KoNaR-Hefajstos/MMS3_hat_thermocouple/jlcpcb/production_files/BOM-MMS3_hat_templates.csv

Comment | Designator | Footprint | LCSC | Quantity
100nF | C1,C10,C11,C12,C2,C4,C5,C6,C7,C8,C9 | C_0603 | C14663 | 11
10kΩ | R1,R2,R3,R5,R8,R9 | R_0402 | C25744 | 6
10uF | C16,C17,C18 | C_0603 | C19702 | 3
330Ω | R10,R11,R12,R13,R14,R15,R16,R17,R20 | R_0402 | C25104 | 9
AMS1117 | U13 | SOT-223-3_L6.5-W3.4-P2.30-LS7.0-BR | C6186 | 1
M24C64 | U2 | SOIC-8_L5.0-W4.0-P1.27-LS6.0-BL | C79988 | 1
MAX31855KASA+T | U16,U17,U18,U19,U20,U21,U22,U5 | SO-8_L4.9-W3.9-P1.27-LS5.9-BL | C52028 | 8
Red | D11,D12,D13,D14,D15,D16,D17,D18,D20 | D_0603 | C2286 | 9
SN74CB3Q3245PWR | U1 | TSSOP-20_L6.5-W4.4-P0.65-LS6.4-BL | C470961 | 1
TCA9535PWR_C130204 | U14 | TSSOP-24_L7.8-W4.4-P0.65-LS6.4-BL | C130204 | 1
