KoNaR-Hefajstos/MMS3_hat_thermocouple/MMS3_hat_templates.kicad_pcb

## KiCad design MMS3_hat_templates.kicad_pcb (2026-06-24)

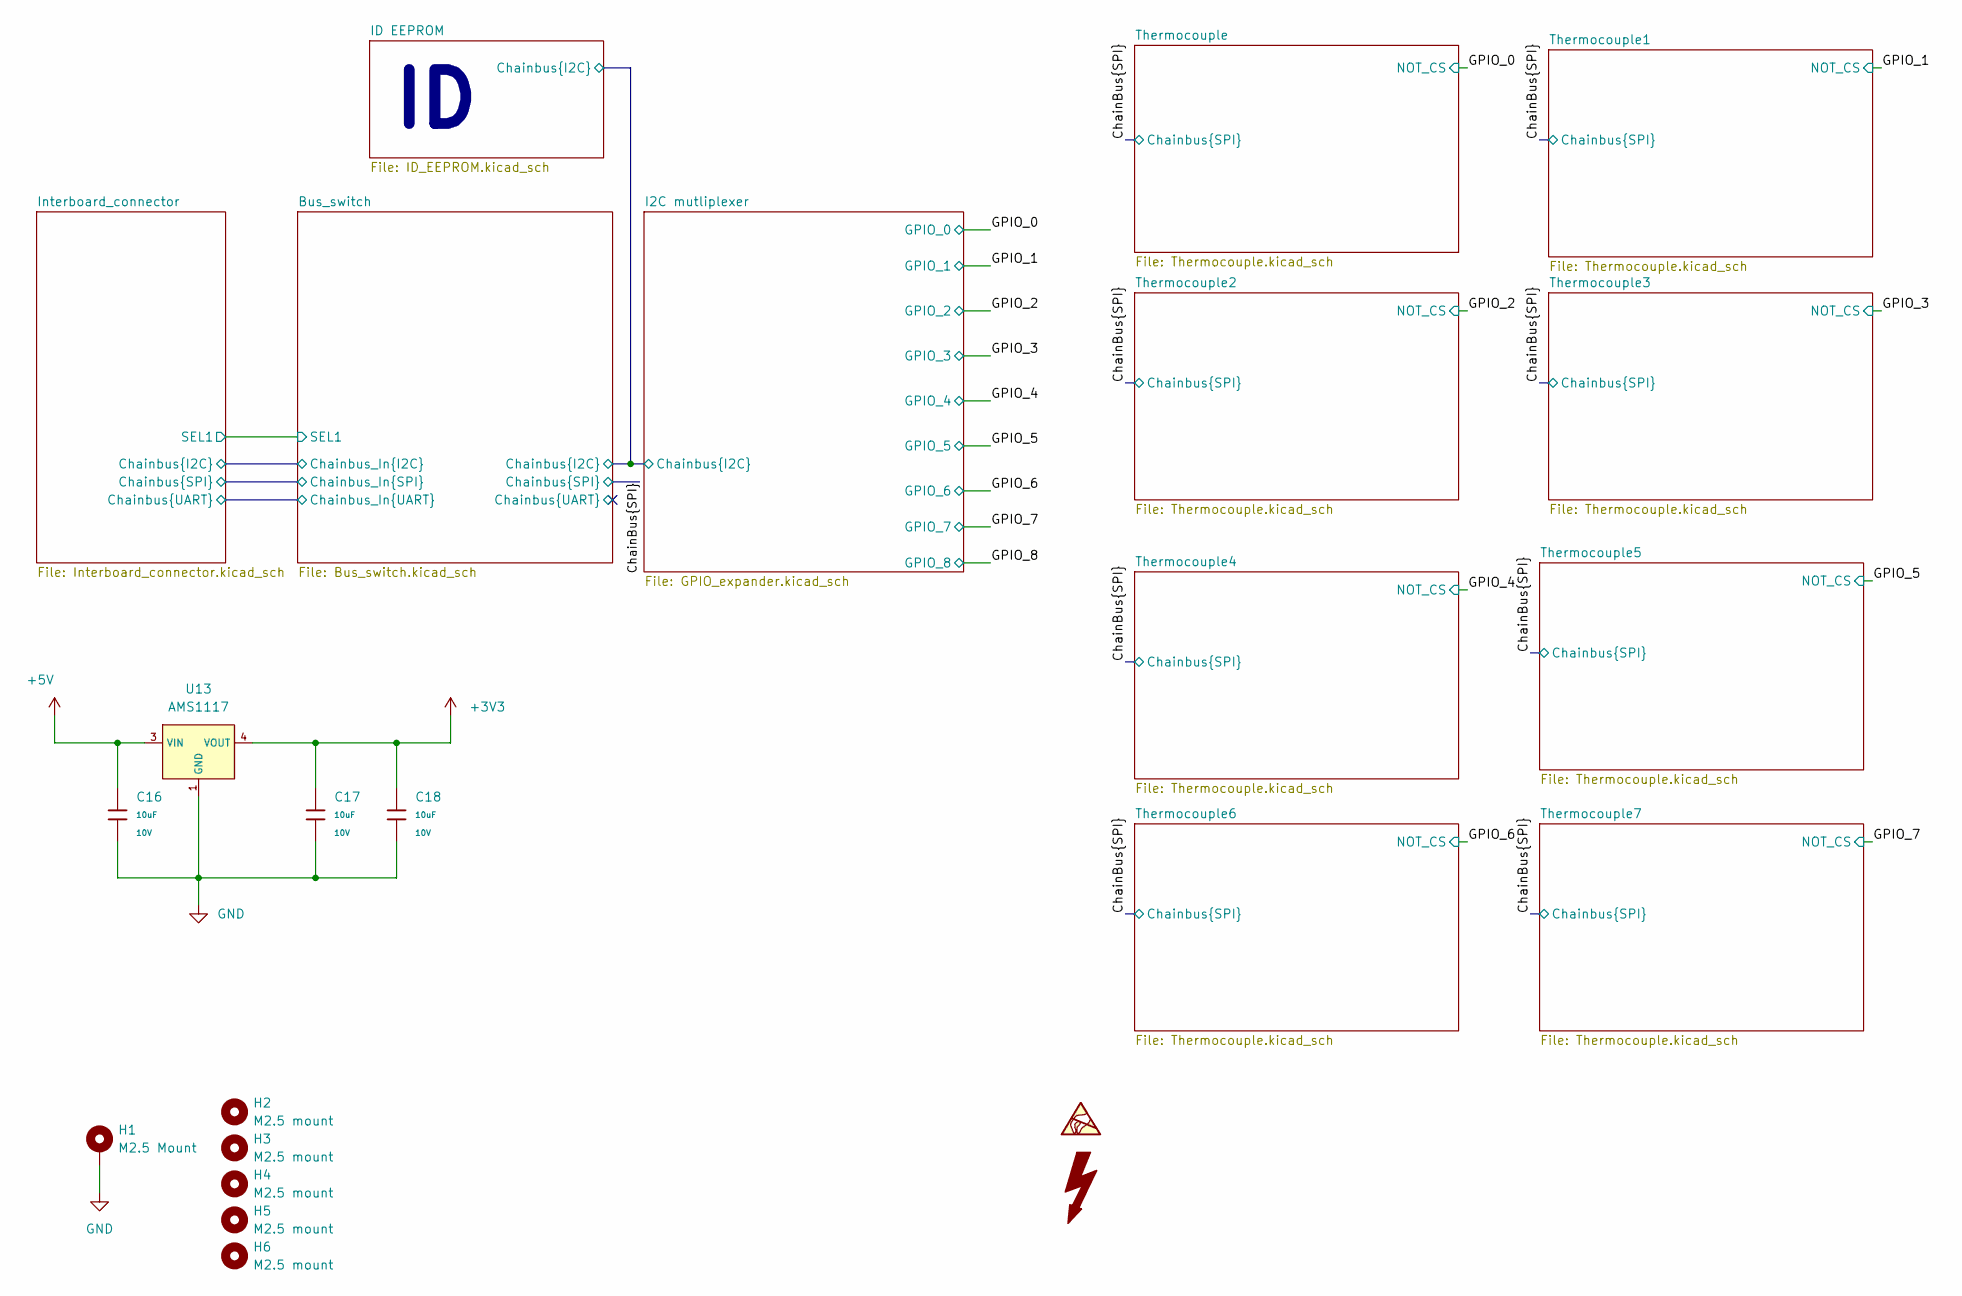
[picture p2: schematic MMS3_hat_templates.kicad_sch, MMS3 Hat template small (Change Me)]

Parts:
C16, C17, C18: 10uF; C_0603; Voltage Rated 10V; Tolerance ±10%; Part CL10A106KP8NNNC; LCSC C19702
H1: M2.5 Mount; MountingHole_2.7mm_M2.5_DIN965_Pad_TopOnly
H2, H3, H4, H5, H6: M2.5 mount; MountingHole_2.7mm_M2.5
U13: AMS1117; SOT-223-3_L6.5-W3.4-P2.30-LS7.0-BR; Output Voltage 3.3V; Dropout Voltage 1.3V@(800mA); Part AMS1117-3.3; LCSC C6186

Connections:
+3V3: C17.1, C18.1, U13.2 (VOUT), U13.4 (VOUT); also elsewhere on the board
+5V: C16.1, U13.3 (VIN); also elsewhere on the board
GND: C16.2, C17.2, C18.2, H1.1 (1_1), U13.1 (GND); also elsewhere on the board

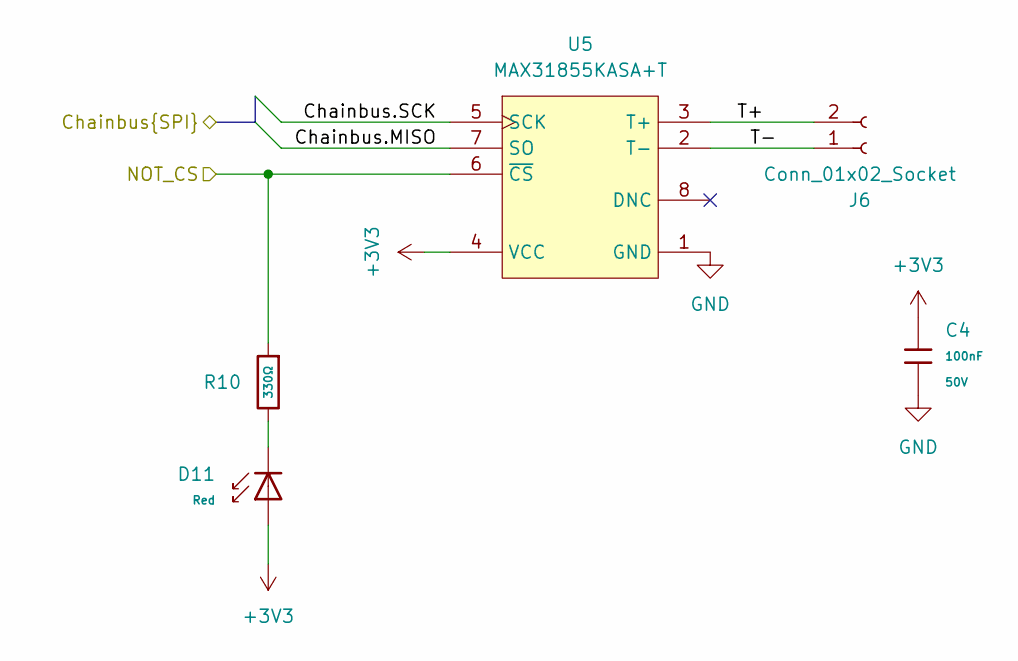
[picture p3: schematic Thermocouple.kicad_sch]

Parts:
C4: 100nF; C_0603; Voltage Rated 50V; Tolerance ±10%; Part CC0603KRX7R9BB104; LCSC C14663
D11: Red; D_0603; Part KT-0603R; LCSC C2286
J6: Conn_01x02_Socket; JST_XH_S2B-XH-A_1x02_P2.50mm_Horizontal
R10: 330Ω; R_0402; Overload Voltage (Max) 50V; Tolerance ±1%; Part 0402WGF3300TCE; LCSC C25104
U5: MAX31855KASA+T; SO-8_L4.9-W3.9-P1.27-LS5.9-BL; MPN MAX31855KASA+T; LCSC Part C52028

Connections:
+3V3: C4.1, D11.2, U5.4 (VCC); also elsewhere on the board
/ChainBus.MISO: U5.7 (SO); also elsewhere on the board
/ChainBus.SCK: U5.5 (SCK); also elsewhere on the board
/GPIO_1: R10.1, U5.6 (~CS); also elsewhere on the board
/Thermocouple1/T+: J6.2, U5.3 (T+)
/Thermocouple1/T-: J6.1, U5.2 (T-)
GND: C4.2, U5.1 (GND); also elsewhere on the board
unnamed: D11.1, R10.2

Parts of its further copies:
C5, C6, C7, C8, C9, C10, C11: 100nF; C_0603; Voltage Rated 50V; Tolerance ±10%; Part CC0603KRX7R9BB104; LCSC C14663
D12, D13, D14, D15, D16, D17, D18: Red; D_0603; Part KT-0603R; LCSC C2286
J7, J8, J9, J10, J11, J12, J13: Conn_01x02_Socket; JST_XH_S2B-XH-A_1x02_P2.50mm_Horizontal
R11, R12, R13, R14, R15, R16, R17: 330Ω; R_0402; Overload Voltage (Max) 50V; Tolerance ±1%; Part 0402WGF3300TCE; LCSC C25104
U16, U17, U18, U19, U20, U21, U22: MAX31855KASA+T; SO-8_L4.9-W3.9-P1.27-LS5.9-BL; MPN MAX31855KASA+T; LCSC Part C52028

Connections of its further copies:
+3V3: C5.1, C6.1, C7.1, C8.1, C9.1, C10.1, C11.1, D12.2, D13.2, D14.2, D15.2, D16.2, D17.2, D18.2, U16.4 (VCC), U17.4 (VCC), U18.4 (VCC), U19.4 (VCC), U20.4 (VCC), U21.4 (VCC), U22.4 (VCC); also elsewhere on the board
/ChainBus.MISO: U16.7 (SO), U17.7 (SO), U18.7 (SO), U19.7 (SO), U20.7 (SO), U21.7 (SO), U22.7 (SO); also elsewhere on the board
/ChainBus.SCK: U16.5 (SCK), U17.5 (SCK), U18.5 (SCK), U19.5 (SCK), U20.5 (SCK), U21.5 (SCK), U22.5 (SCK); also elsewhere on the board
/GPIO_0: R11.1, U16.6 (~CS); also elsewhere on the board
/GPIO_2: R12.1, U17.6 (~CS); also elsewhere on the board
/GPIO_3: R13.1, U18.6 (~CS); also elsewhere on the board
/GPIO_4: R14.1, U19.6 (~CS); also elsewhere on the board
/GPIO_5: R15.1, U20.6 (~CS); also elsewhere on the board
/GPIO_6: R16.1, U21.6 (~CS); also elsewhere on the board
/GPIO_7: R17.1, U22.6 (~CS); also elsewhere on the board
/Thermocouple2/T+: J8.2, U17.3 (T+)
/Thermocouple2/T-: J8.1, U17.2 (T-)
/Thermocouple3/T+: J9.2, U18.3 (T+)
/Thermocouple3/T-: J9.1, U18.2 (T-)
/Thermocouple4/T+: J10.2, U19.3 (T+)
/Thermocouple4/T-: J10.1, U19.2 (T-)
/Thermocouple5/T+: J11.2, U20.3 (T+)
/Thermocouple5/T-: J11.1, U20.2 (T-)
/Thermocouple6/T+: J12.2, U21.3 (T+)
/Thermocouple6/T-: J12.1, U21.2 (T-)
/Thermocouple7/T+: J13.2, U22.3 (T+)
/Thermocouple7/T-: J13.1, U22.2 (T-)
/Thermocouple/T+: J7.2, U16.3 (T+)
/Thermocouple/T-: J7.1, U16.2 (T-)
GND: C5.2, C6.2, C7.2, C8.2, C9.2, C10.2, C11.2, U16.1 (GND), U17.1 (GND), U18.1 (GND), U19.1 (GND), U20.1 (GND), U21.1 (GND), U22.1 (GND); also elsewhere on the board
unnamed: D12.1, R11.2
unnamed: D13.1, R12.2
unnamed: D14.1, R13.2
unnamed: D15.1, R14.2
unnamed: D16.1, R15.2
unnamed: D17.1, R16.2
unnamed: D18.1, R17.2

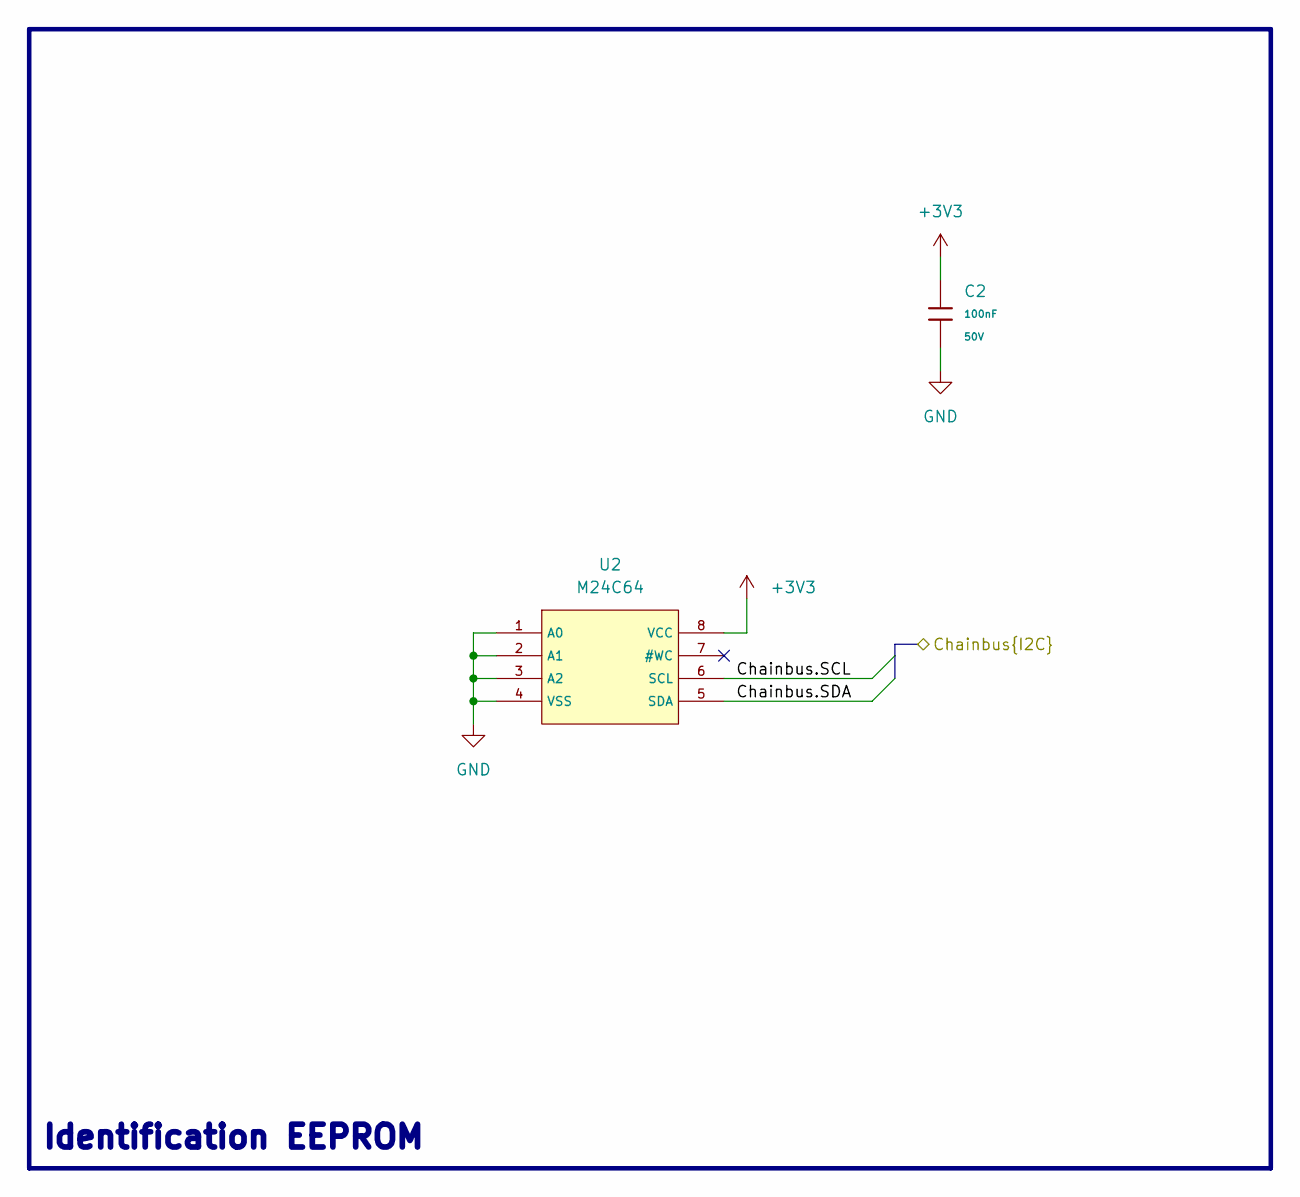
[picture p4: schematic ID_EEPROM.kicad_sch, MMS3 Stepper Controler]

Parts:
C2: 100nF; C_0603; Voltage Rated 50V; Tolerance ±10%; Part CC0603KRX7R9BB104; LCSC C14663
U2: M24C64; SOIC-8_L5.0-W4.0-P1.27-LS6.0-BL; Supply Voltage 1.8V~5.5V; Part M24C64-RMN6TP; LCSC C79988

Connections:
+3V3: C2.1, U2.8 (VCC); also elsewhere on the board
/Bus_switch/Chainbus.SCL: U2.6 (SCL); also elsewhere on the board
/Bus_switch/Chainbus.SDA: U2.5 (SDA); also elsewhere on the board
GND: C2.2, U2.1 (A0), U2.2 (A1), U2.3 (A2), U2.4 (VSS); also elsewhere on the board

Notes on the sheet:
Identification EEPROM

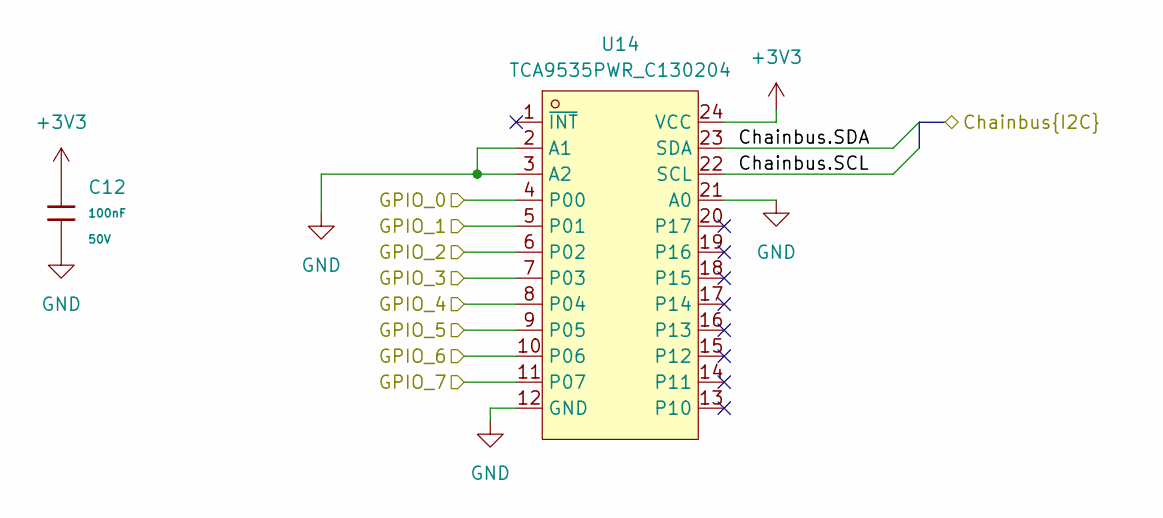
[picture p5: schematic GPIO_expander.kicad_sch]

Parts:
C12: 100nF; C_0603; Voltage Rated 50V; Tolerance ±10%; Part CC0603KRX7R9BB104; LCSC C14663
U14: TCA9535PWR_C130204; TSSOP-24_L7.8-W4.4-P0.65-LS6.4-BL; MPN TCA9535PWR; LCSC Part C130204

Connections:
+3V3: C12.1, U14.24 (VCC); also elsewhere on the board
/Bus_switch/Chainbus.SCL: U14.22 (SCL); also elsewhere on the board
/Bus_switch/Chainbus.SDA: U14.23 (SDA); also elsewhere on the board
/GPIO_0: U14.4 (P00); also elsewhere on the board
/GPIO_1: U14.5 (P01); also elsewhere on the board
/GPIO_2: U14.6 (P02); also elsewhere on the board
/GPIO_3: U14.7 (P03); also elsewhere on the board
/GPIO_4: U14.8 (P04); also elsewhere on the board
/GPIO_5: U14.9 (P05); also elsewhere on the board
/GPIO_6: U14.10 (P06); also elsewhere on the board
/GPIO_7: U14.11 (P07); also elsewhere on the board
GND: C12.2, U14.2 (A1), U14.3 (A2), U14.12 (GND), U14.21 (A0); also elsewhere on the board

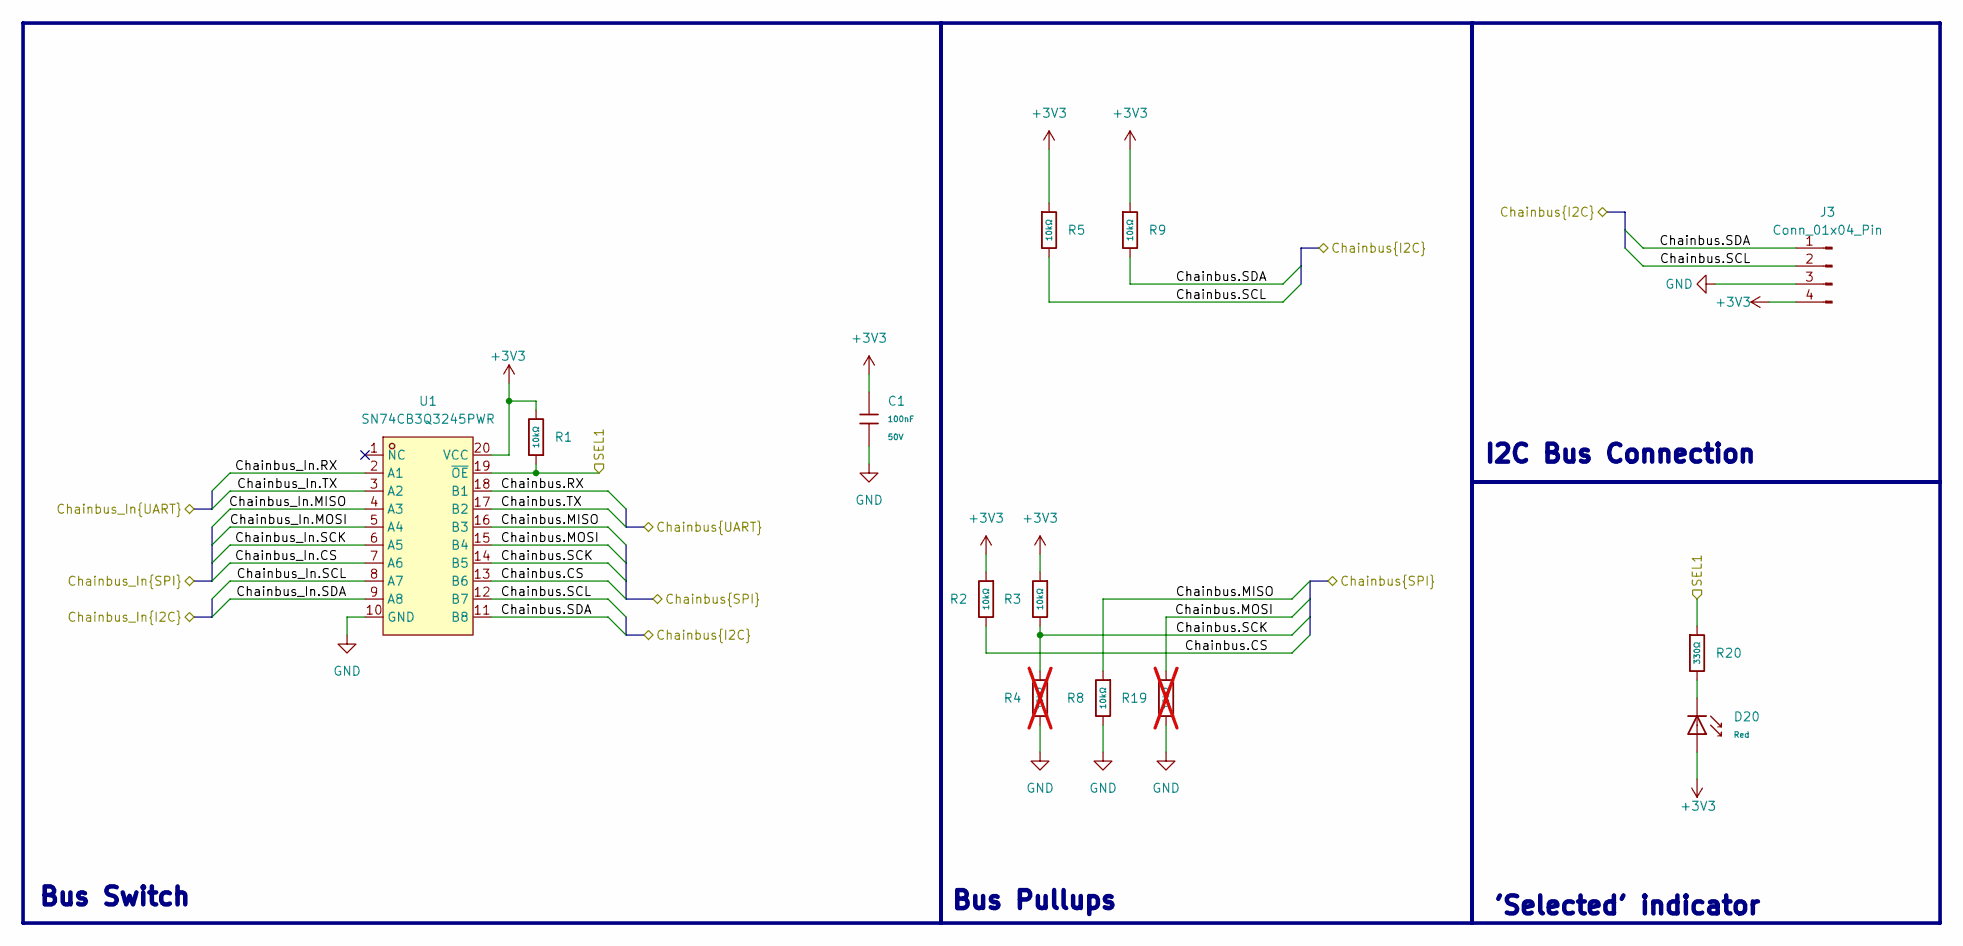
[picture p6: schematic Bus_switch.kicad_sch, MMS3 Hat template small (Change Me)]

Parts:
C1: 100nF; C_0603; Voltage Rated 50V; Tolerance ±10%; Part CC0603KRX7R9BB104; LCSC C14663
D20: Red; D_0603; Part KT-0603R; LCSC C2286
J3: Conn_01x04_Pin; PinHeader_1x04_P2.54mm_Vertical
R1, R2, R3, R5, R8, R9: 10kΩ; R_0402; Overload Voltage (Max) 50V; Tolerance ±1%; Part 0402WGF1002TCE; LCSC C25744
R4, R19: 10kΩ; R_0402; Overload Voltage (Max) 50V; Tolerance ±1%; Part 0402WGF1002TCE; LCSC C25744; not fitted
R20: 330Ω; R_0402; Overload Voltage (Max) 50V; Tolerance ±1%; Part 0402WGF3300TCE; LCSC C25104
U1: SN74CB3Q3245PWR; TSSOP-20_L6.5-W4.4-P0.65-LS6.4-BL; MPN SN74CB3Q3245PWR; LCSC Part C470961

Connections:
+3V3: C1.1, D20.2, J3.4, R1.2, R2.1, R3.1, R5.1, R9.1, U1.20 (VCC); also elsewhere on the board
/Bus_switch/Chainbus.RX: U1.18 (B1)
/Bus_switch/Chainbus.SCL: J3.2, R5.2, U1.12 (B7); also elsewhere on the board
/Bus_switch/Chainbus.SDA: J3.1, R9.2, U1.11 (B8); also elsewhere on the board
/Bus_switch/Chainbus.TX: U1.17 (B2)
/Bus_switch/Chainbus_In.CS: U1.7 (A6); also elsewhere on the board
/Bus_switch/Chainbus_In.MISO: U1.4 (A3); also elsewhere on the board
/Bus_switch/Chainbus_In.MOSI: U1.5 (A4); also elsewhere on the board
/Bus_switch/Chainbus_In.RX: U1.2 (A1); also elsewhere on the board
/Bus_switch/Chainbus_In.SCK: U1.6 (A5); also elsewhere on the board
/Bus_switch/Chainbus_In.SCL: U1.8 (A7); also elsewhere on the board
/Bus_switch/Chainbus_In.SDA: U1.9 (A8); also elsewhere on the board
/Bus_switch/Chainbus_In.TX: U1.3 (A2); also elsewhere on the board
/Bus_switch/SEL1: R1.1, R20.1, U1.19 (~OE); also elsewhere on the board
/ChainBus.CS: R2.2, U1.13 (B6)
/ChainBus.MISO: R8.1, U1.16 (B3); also elsewhere on the board
/ChainBus.MOSI: R19.1, U1.15 (B4)
/ChainBus.SCK: R3.2, R4.1, U1.14 (B5); also elsewhere on the board
GND: C1.2, J3.3, R4.2, R8.2, R19.2, U1.10 (GND); also elsewhere on the board
unnamed: D20.1, R20.2

Notes on the sheet:
Bus Switch
Bus Pullups
'Selected' indicator
I2C Bus Connection

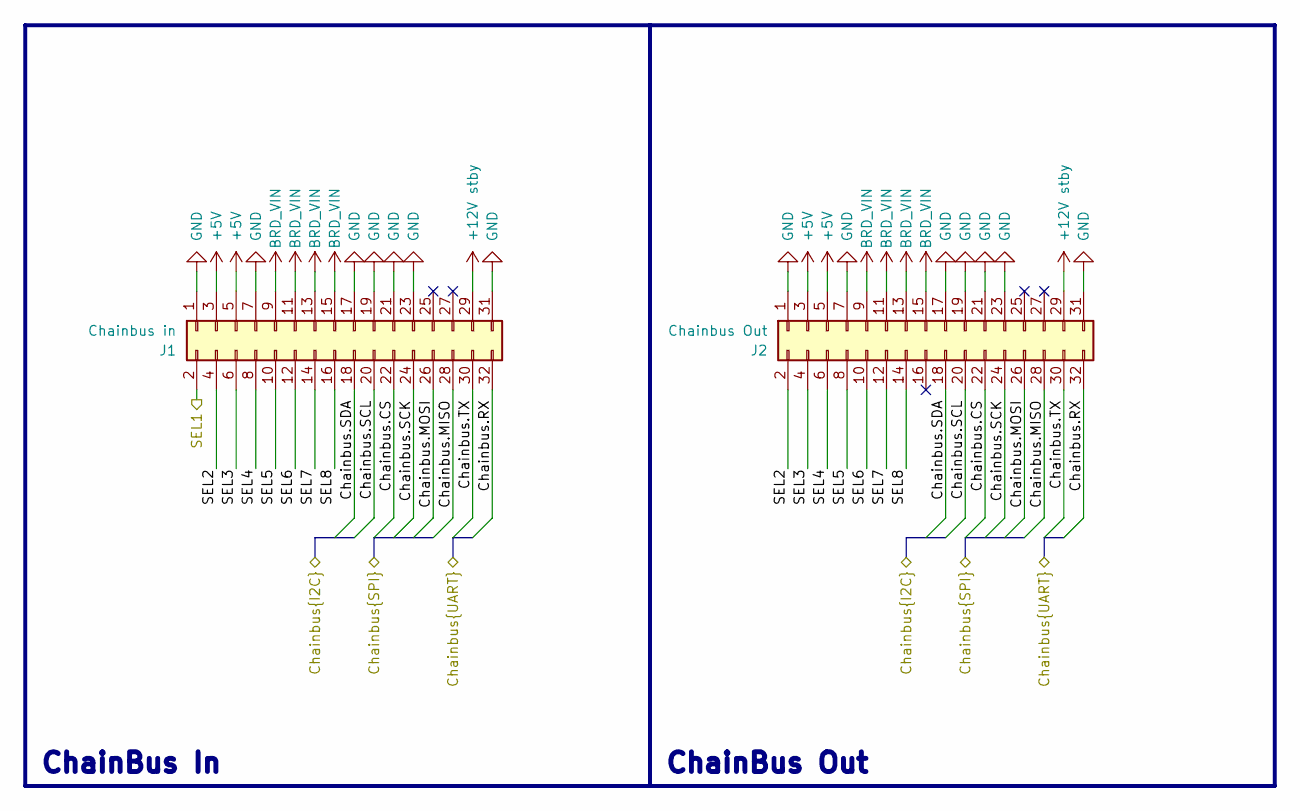
[picture p7: schematic Interboard_connector.kicad_sch, MMS3 Stepper Controler]

Parts:
J1: Chainbus in; PinHeader_2x16_P2.54mm_Vertical_SMD
J2: Chainbus Out; PinSocket_2x16_P2.54mm_Vertical_SMD

Connections:
+5V: J1.3, J1.5, J2.3, J2.5; also elsewhere on the board
+12V stby: J1.29, J2.29
/Bus_switch/Chainbus_In.CS: J1.22, J2.22; also elsewhere on the board
/Bus_switch/Chainbus_In.MISO: J1.28, J2.28; also elsewhere on the board
/Bus_switch/Chainbus_In.MOSI: J1.26, J2.26; also elsewhere on the board
/Bus_switch/Chainbus_In.RX: J1.32, J2.32; also elsewhere on the board
/Bus_switch/Chainbus_In.SCK: J1.24, J2.24; also elsewhere on the board
/Bus_switch/Chainbus_In.SCL: J1.20, J2.20; also elsewhere on the board
/Bus_switch/Chainbus_In.SDA: J1.18, J2.18; also elsewhere on the board
/Bus_switch/Chainbus_In.TX: J1.30, J2.30; also elsewhere on the board
/Bus_switch/SEL1: J1.2; also elsewhere on the board
/Interboard_connector/SEL2: J1.4, J2.2
/Interboard_connector/SEL3: J1.6, J2.4
/Interboard_connector/SEL4: J1.8, J2.6
/Interboard_connector/SEL5: J1.10, J2.8
/Interboard_connector/SEL6: J1.12, J2.10
/Interboard_connector/SEL7: J1.14, J2.12
/Interboard_connector/SEL8: J1.16, J2.14
BRD_VIN: J1.9, J1.11, J1.13, J1.15, J2.9, J2.11, J2.13, J2.15
GND: J1.1, J1.7, J1.17, J1.19, J1.21, J1.23, J1.31, J2.1, J2.7, J2.17, J2.19, J2.21, J2.23, J2.31; also elsewhere on the board

Notes on the sheet:
ChainBus In
ChainBus Out

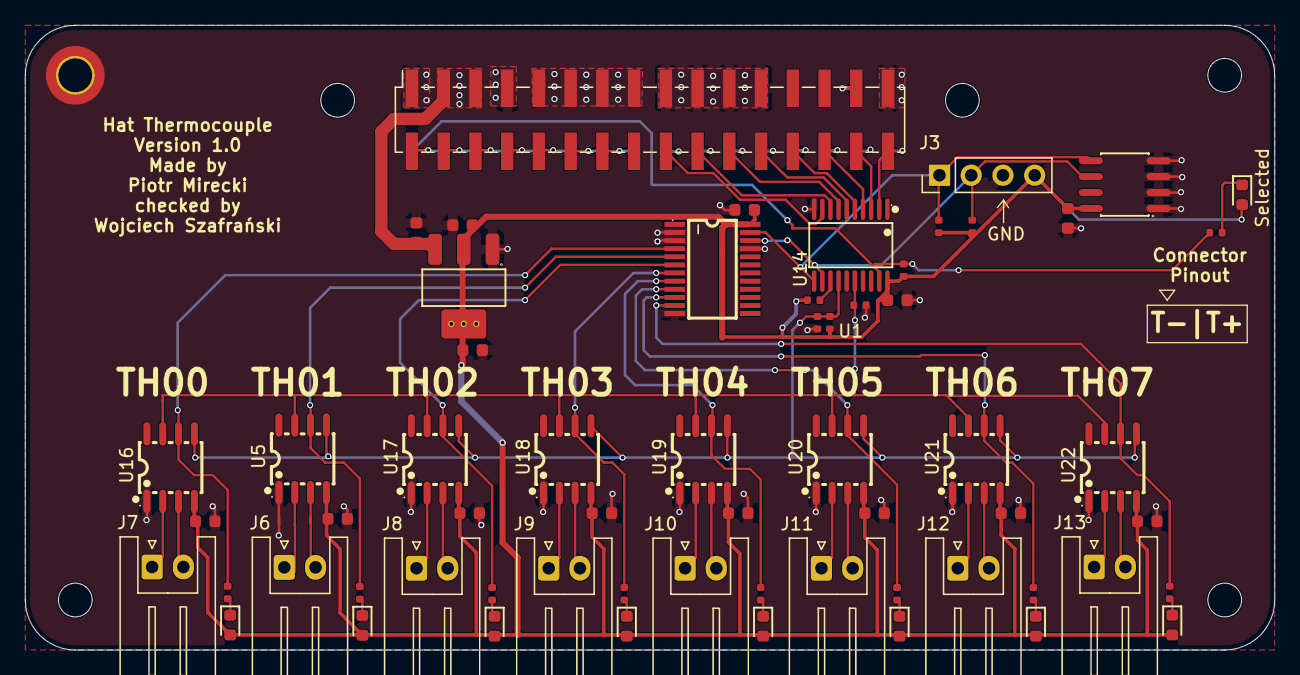
[picture p8: board MMS3_hat_templates.kicad_pcb from above]

Board: 2 copper layers, 100.0 x 50.0 mm, 68 parts (1 on the bottom side), 59 nets.
