KoNaR-Hefajstos/MMS3_hat_thermocouple/(commit log)

2026-02-26 template board cleansed
2026-04-18 fixed selected led polarity
2026-04-20 generated final gerber
2026-06-24 updated silkscreen
